HenryR-B/bio-robot/battery-motherboard/battery-motherboard.step

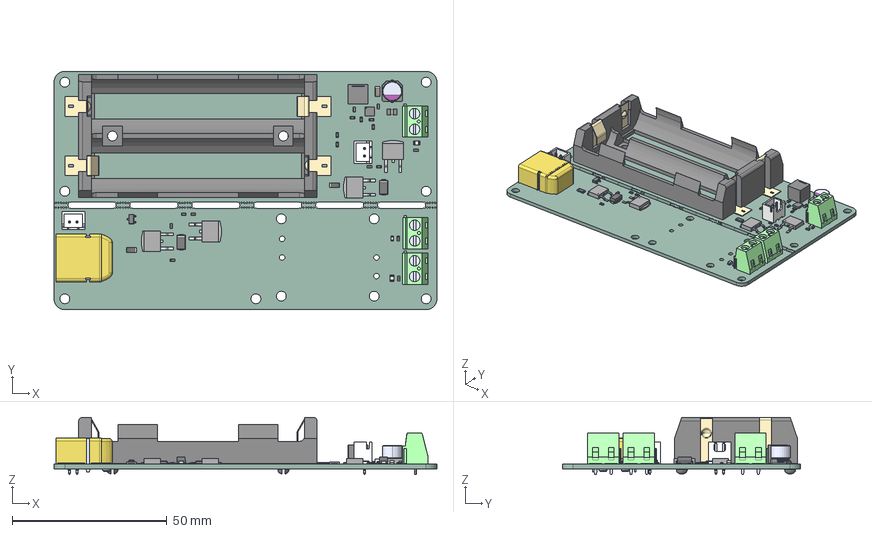
[picture p1: CAD file, 2026-03-27]
battery-motherboard/battery-motherboard.step
123.8 x 77.0 x 18.5 mm
LED_0805_2012Metric x 2
R_0603_1608Metric x 15
SOT23-3
282837-2--3DModel-STEP-269445 x 3
C_1206_3216Metric
D_SMA x 2
DPAK-3_ONS x 4
LMR51450SDRRR
LED_0603_1608Metric
B2B-XH-A_LF__SN_ x 2
C_0805_2012Metric x 2
C_0603_1608Metric x 2
XAL6060-472MEC
XT60PW-M
1048P
Fuse_1206_3216Metric x 2
10SVPC120MV
motherboard-esp32_PCB
