HenryR-B/bio-robot/control-board/control-board.step

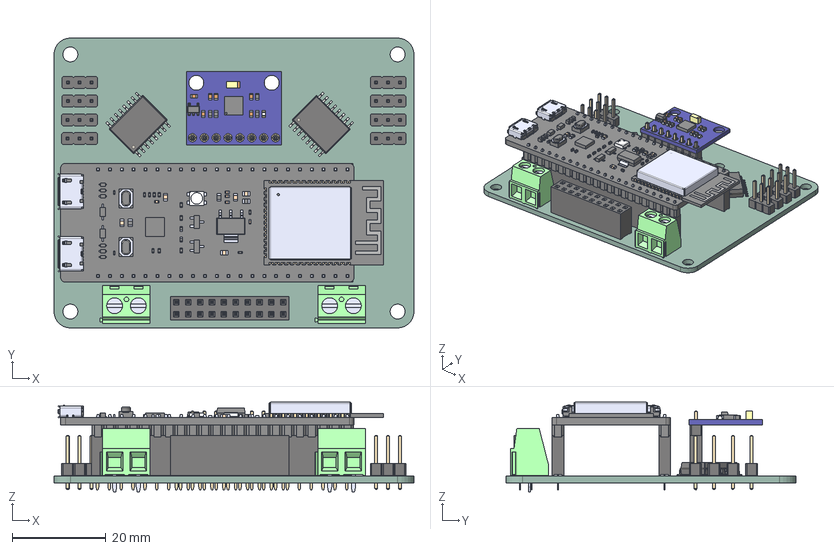
[picture p2: CAD file, 2026-04-10]
control-board/control-board.step
77.0 x 62.0 x 19.1 mm
282837-2--3DModel-STEP-269445 x 2
PinHeader_1x03_P2.54mm_Vertical x 8
SOIC-16W_7.5x10.3mm_P1.27mm x 2
PinSocket_2x10_P2.54mm_Vertical
ESP32-S3-DEVKITC-1-N8R8
PinSocket_1x22_P2.54mm_Vertical x 2
OC09600
PinHeader_1x08_P2.54mm_Vertical
PinSocket_1x08_P2.54mm_Vertical
servo-board_PCB
