HenryR-B/bio-robot/dc-dc-6.8V/dc-dc6.8V.step

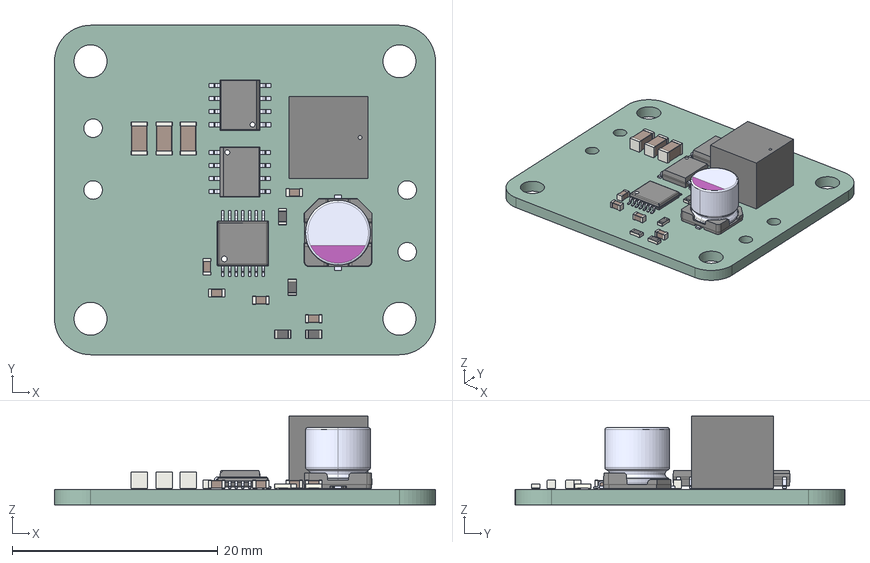
[picture p3: CAD file, 2026-03-26]
dc-dc-6.8V/dc-dc6.8V.step
37.0 x 32.0 x 8.61 mm
C_0603_1608Metric x 5
AO4354 x 2
C_1206_3216Metric x 3
IND_XAL7070_COC
10SVPC120MV
R_0603_1608Metric x 4
LM3150MHX_NOPB
dc-dc-6.8V_PCB
