HenryR-B/bio-robot/control-board/control-board.kicad_pcb

## KiCad design control-board/control-board.kicad_pcb (2026-03-26)

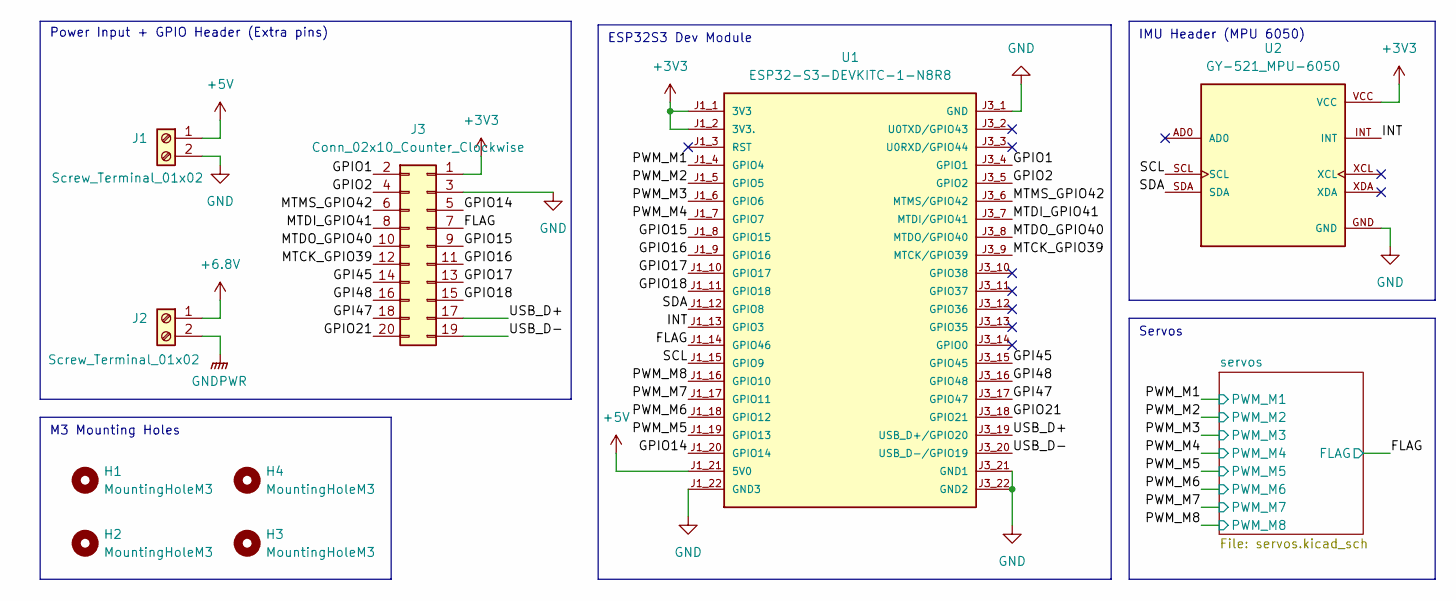
[picture p4: schematic control-board.kicad_sch]

Parts:
H1, H2, H3, H4: MountingHoleM3; MountingHole_3.2mm_M3_DIN965_Pad
J1, J2: Screw_Terminal_01x02; TerminalBlock_MaiXu_MX126-5.0-02P_1x02_P5.00mm
J3: Conn_02x10_Counter_Clockwise; PinSocket_2x10_P2.54mm_Vertical
U1: ESP32-S3-DEVKITC-1-N8R8
U2: GY-521_MPU-6050; MODULE_OC09600; PARTREV NA

Connections:
+3V3: J3.1, U1.J1_1 (3V3), U1.J1_2 (3V3.), U2.VCC; also elsewhere on the board
+5V: J1.1, U1.J1_21 (5V0)
+6.8V: J2.1; also elsewhere on the board
/FLAG: J3.7, U1.J1_14 (GPIO46); also elsewhere on the board
/GPI45: J3.14, U1.J3_15 (GPIO45)
/GPI47: J3.18, U1.J3_17 (GPIO47)
/GPI48: J3.16, U1.J3_16 (GPIO48)
/GPIO1: J3.2, U1.J3_4 (GPIO1)
/GPIO2: J3.4, U1.J3_5 (GPIO2)
/GPIO14: J3.5, U1.J1_20 (GPIO14)
/GPIO15: J3.9, U1.J1_8 (GPIO15)
/GPIO16: J3.11, U1.J1_9 (GPIO16)
/GPIO17: J3.13, U1.J1_10 (GPIO17)
/GPIO18: J3.15, U1.J1_11 (GPIO18)
/GPIO21: J3.20, U1.J3_18 (GPIO21)
/INT: U1.J1_13 (GPIO3), U2.INT
/MTCK_GPIO39: J3.12, U1.J3_9 (MTCK/GPIO39)
/MTDI_GPIO41: J3.8, U1.J3_7 (MTDI/GPIO41)
/MTDO_GPIO40: J3.10, U1.J3_8 (MTDO/GPIO40)
/MTMS_GPIO42: J3.6, U1.J3_6 (MTMS/GPIO42)
/PWM_M1: U1.J1_4 (GPIO4); also elsewhere on the board
/PWM_M2: U1.J1_5 (GPIO5); also elsewhere on the board
/PWM_M3: U1.J1_6 (GPIO6); also elsewhere on the board
/PWM_M4: U1.J1_7 (GPIO7); also elsewhere on the board
/PWM_M5: U1.J1_19 (GPIO13); also elsewhere on the board
/PWM_M6: U1.J1_18 (GPIO12); also elsewhere on the board
/PWM_M7: U1.J1_17 (GPIO11); also elsewhere on the board
/PWM_M8: U1.J1_16 (GPIO10); also elsewhere on the board
/SCL: U1.J1_15 (GPIO9), U2.SCL
/SDA: U1.J1_12 (GPIO8), U2.SDA
/USB_D+: J3.17, U1.J3_19 (USB_D+/GPIO20)
/USB_D-: J3.19, U1.J3_20 (USB_D-/GPIO19)
GND: J1.2, J3.3, U1.J1_22 (GND3), U1.J3_1 (GND), U1.J3_21 (GND1), U1.J3_22 (GND2), U2.GND; also elsewhere on the board
GNDPWR: J2.2; also elsewhere on the board

Notes on the sheet:
IMU Header (MPU 6050)
Servos
ESP32S3 Dev Module
M3 Mounting Holes
Power Input + GPIO Header (Extra pins)

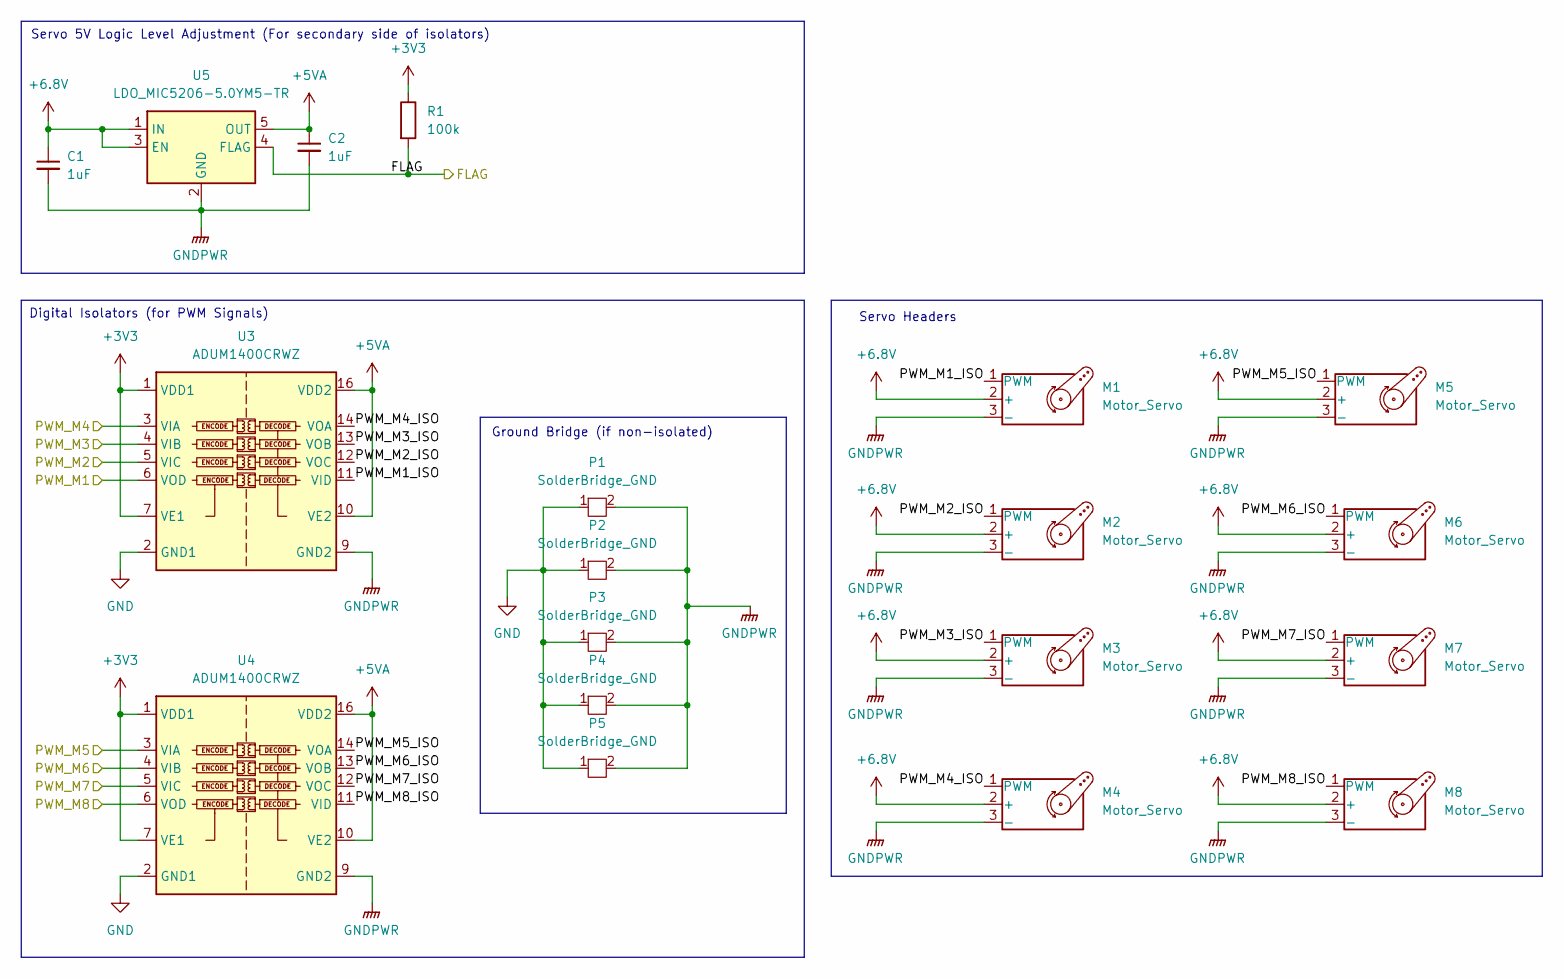
[picture p5: schematic servos.kicad_sch]

Parts:
C1, C2: 1uF; C_0603_1608Metric; MPN CL10A105KB8NNNC; LCSC C15849
M1, M2, M3, M4, M5, M6, M7, M8: Motor_Servo; PinHeader_1x03_P2.54mm_Vertical
P1, P2, P3, P4, P5: SolderBridge_GND
R1: 100k; R_0603_1608Metric; MPN 0603WAF1003T5E; JLC 0603
U3, U4: ADUM1400CRWZ; SOIC-16W_7.5x10.3mm_P1.27mm
U5: LDO_MIC5206-5.0YM5-TR; SOT-23-5

Connections:
+3V3: R1.1, U3.1 (VDD1), U3.7 (VE1), U4.1 (VDD1), U4.7 (VE1); also elsewhere on the board
+5VA: C2.1, U3.10 (VE2), U3.16 (VDD2), U4.10 (VE2), U4.16 (VDD2), U5.5 (OUT)
+6.8V: C1.1, M1.2 (+), M2.2 (+), M3.2 (+), M4.2 (+), M5.2 (+), M6.2 (+), M7.2 (+), M8.2 (+), U5.1 (IN), U5.3 (EN); also elsewhere on the board
/FLAG: R1.2, U5.4 (FLAG); also elsewhere on the board
/PWM_M1: U3.6 (VOD); also elsewhere on the board
/PWM_M2: U3.5 (VIC); also elsewhere on the board
/PWM_M3: U3.4 (VIB); also elsewhere on the board
/PWM_M4: U3.3 (VIA); also elsewhere on the board
/PWM_M5: U4.3 (VIA); also elsewhere on the board
/PWM_M6: U4.4 (VIB); also elsewhere on the board
/PWM_M7: U4.5 (VIC); also elsewhere on the board
/PWM_M8: U4.6 (VOD); also elsewhere on the board
/servos/PWM_M1_ISO: M1.1 (PWM), U3.11 (VID)
/servos/PWM_M2_ISO: M2.1 (PWM), U3.12 (VOC)
/servos/PWM_M3_ISO: M3.1 (PWM), U3.13 (VOB)
/servos/PWM_M4_ISO: M4.1 (PWM), U3.14 (VOA)
/servos/PWM_M5_ISO: M5.1 (PWM), U4.14 (VOA)
/servos/PWM_M6_ISO: M6.1 (PWM), U4.13 (VOB)
/servos/PWM_M7_ISO: M7.1 (PWM), U4.12 (VOC)
/servos/PWM_M8_ISO: M8.1 (PWM), U4.11 (VID)
GND: P1.1, P2.1, P3.1, P4.1, P5.1, U3.2 (GND1), U3.8 (GND1), U4.2 (GND1), U4.8 (GND1); also elsewhere on the board
GNDPWR: C1.2, C2.2, M1.3 (-), M2.3 (-), M3.3 (-), M4.3 (-), M5.3 (-), M6.3 (-), M7.3 (-), M8.3 (-), P1.2, P2.2, P3.2, P4.2, P5.2, U3.9 (GND2), U3.15 (GND2), U4.9 (GND2), U4.15 (GND2), U5.2 (GND); also elsewhere on the board

Notes on the sheet:
Digital Isolators (for PWM Signals)
Servo 5V Logic Level Adjustment (For secondary side of isolators)
Ground Bridge (if non-isolated)
Servo Headers

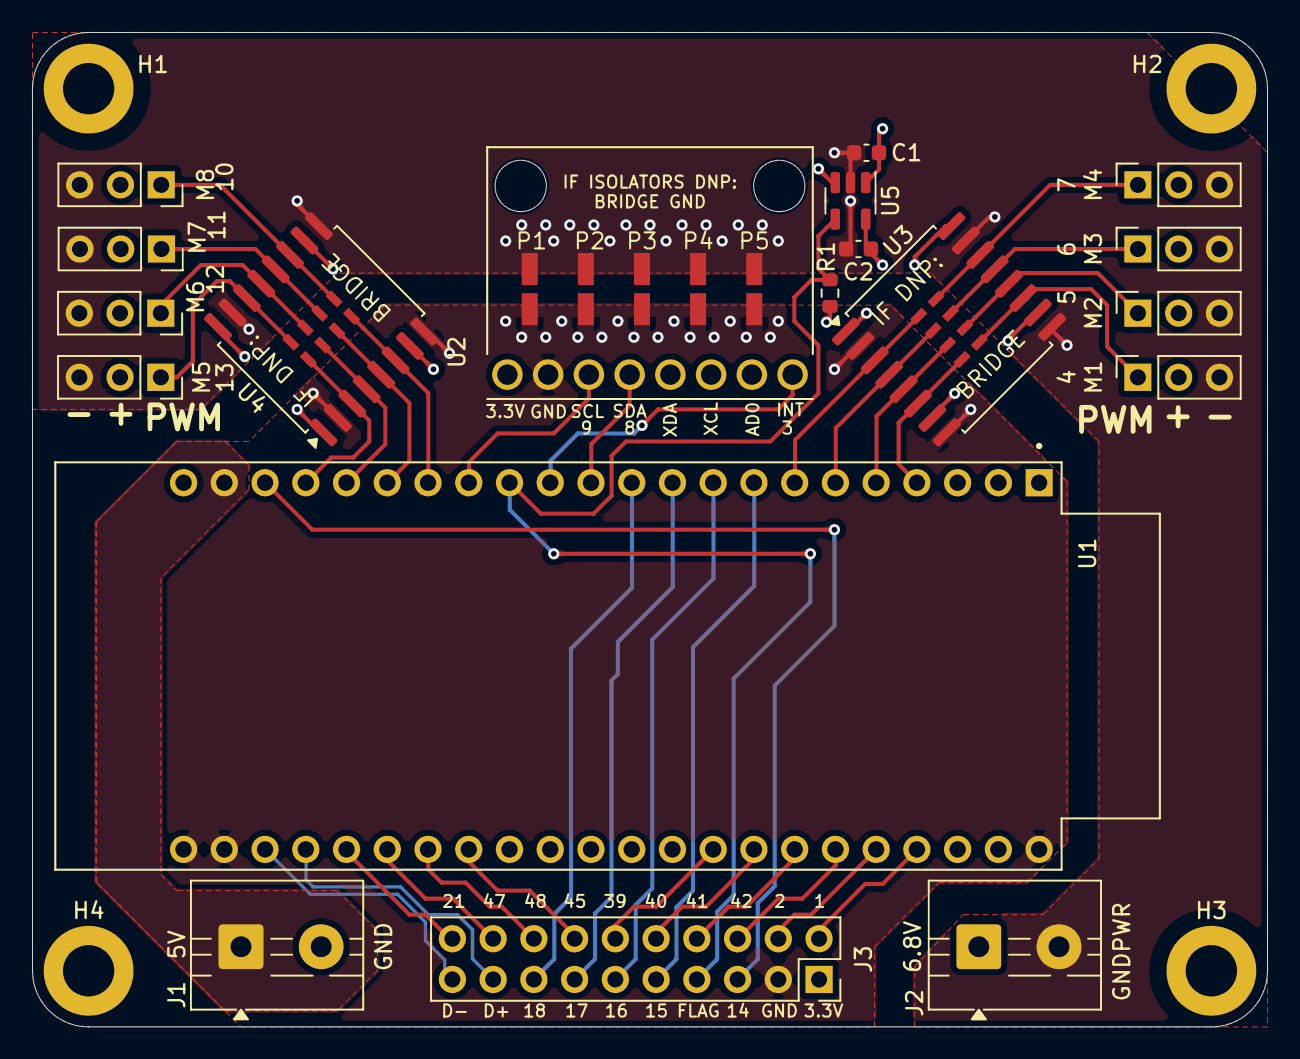
[picture p6: board control-board.kicad_pcb from above]

Board: 4 copper layers, 77.0 x 62.0 mm, 28 parts (0 on the bottom side), 43 nets.
