HenryR-B/bio-robot/battery-motherboard/battery-motherboard.kicad_pcb

## KiCad design battery-motherboard/battery-motherboard.kicad_pcb (2026-04-10)

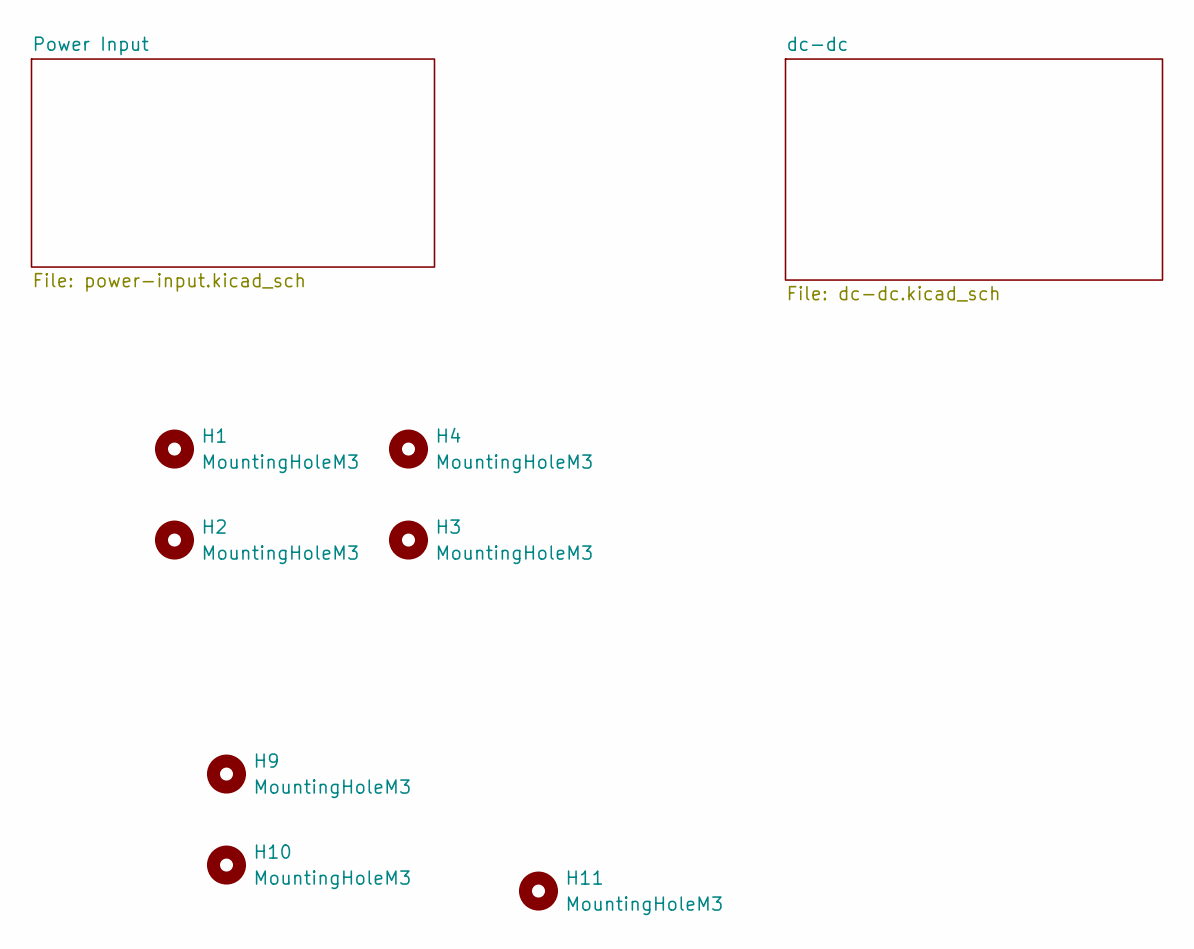
[picture p7: schematic battery-motherboard.kicad_sch]

Parts:
H1, H2, H3, H4, H9, H10, H11: MountingHoleM3; MountingHole_3.2mm_M3_DIN965_Pad

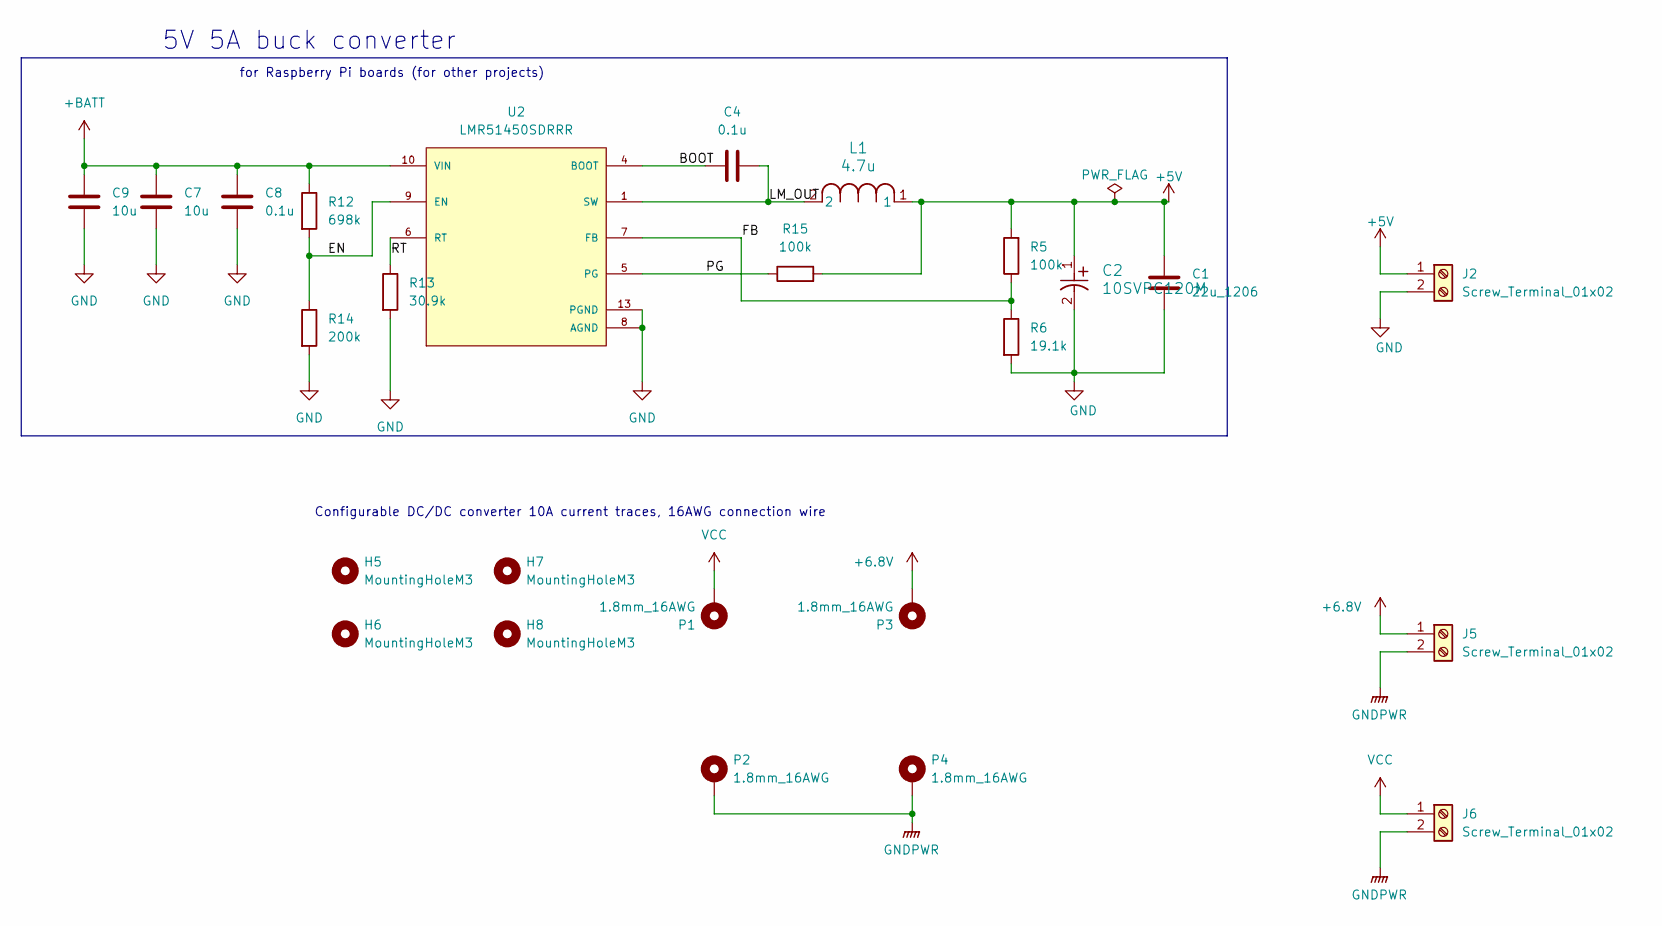
[picture p8: schematic dc-dc.kicad_sch]

Parts:
C1: 22u_1206; C_1206_3216Metric; MPN CL31A226KAHNNNE; JLC 0805
C2: 10SVPC120M; CAP_10SVPC120MV; LCSC C178336
C4, C8: 0.1u; C_0603_1608Metric; MPN CC0603KRX7R9BB104; JLC 0603
C7, C9: 10u; C_0805_2012Metric; MPN GRM21BR61H106KE43L; JLC 0805
H5, H6, H7, H8: MountingHoleM3; MountingHole_3.2mm_M3_DIN965_Pad
J2, J5, J6: Screw_Terminal_01x02; TerminalBlock_MaiXu_MX126-5.0-02P_1x02_P5.00mm
L1: 4.7u; IND_XAL6060-472MEC; MPN XAL6060-472MEB; LCSC C7421717
P1, P2, P3, P4: 1.8mm_16AWG; SolderPad_TH_16AWG_1.8mm
R5, R15: 100k; R_0603_1608Metric; MPN 0603WAF1003T5E; JLC 0603
R6: 19.1k; R_0603_1608Metric; MPN 0603WAF1912T5E; JLC 0603
R12: 698k; R_0603_1608Metric; MPN 0603WAF6983T5E; JLC 0603
R13: 30.9k; R_0603_1608Metric; MPN 0603WAF3092T5E; JLC 0603
R14: 200k; R_0603_1608Metric; MPN 0603WAF2003T5E; JLC 0603
U2: LMR51450SDRRR; CONV_LMR51450SDRRR; PARTREV December 2022

Connections:
+5V: C1.1, C2.1, J2.1, L1.1, R5.2, R15.2; also elsewhere on the board
+6.8V: J5.1, P3.1 (1_1); also elsewhere on the board
+BATT: C7.1, C8.2, C9.1, R12.1, U2.10 (VIN), U2.11 (VIN), U2.12 (VIN); also elsewhere on the board
/dc-dc/BOOT: C4.1, U2.4 (BOOT)
/dc-dc/EN: R12.2, R14.1, U2.9 (EN)
/dc-dc/FB: R5.1, R6.1, U2.7 (FB)
/dc-dc/LM_OUT: C4.2, L1.2, U2.1 (SW), U2.2 (SW), U2.3 (SW)
/dc-dc/PG: R15.1, U2.5 (PG)
/dc-dc/RT: R13.1, U2.6 (RT)
GND: C1.2, C2.2, C7.2, C8.1, C9.2, J2.2, R6.2, R13.2, R14.2, U2.8 (AGND), U2.13 (PGND); also elsewhere on the board
GNDPWR: J5.2, J6.2, P2.1 (1_1), P4.1 (1_1); also elsewhere on the board
VCC: J6.1, P1.1 (1_1); also elsewhere on the board

Notes on the sheet:
Configurable DC/DC converter 10A current traces, 16AWG connection wire
5V 5A buck converter
for Raspberry Pi boards (for other projects)

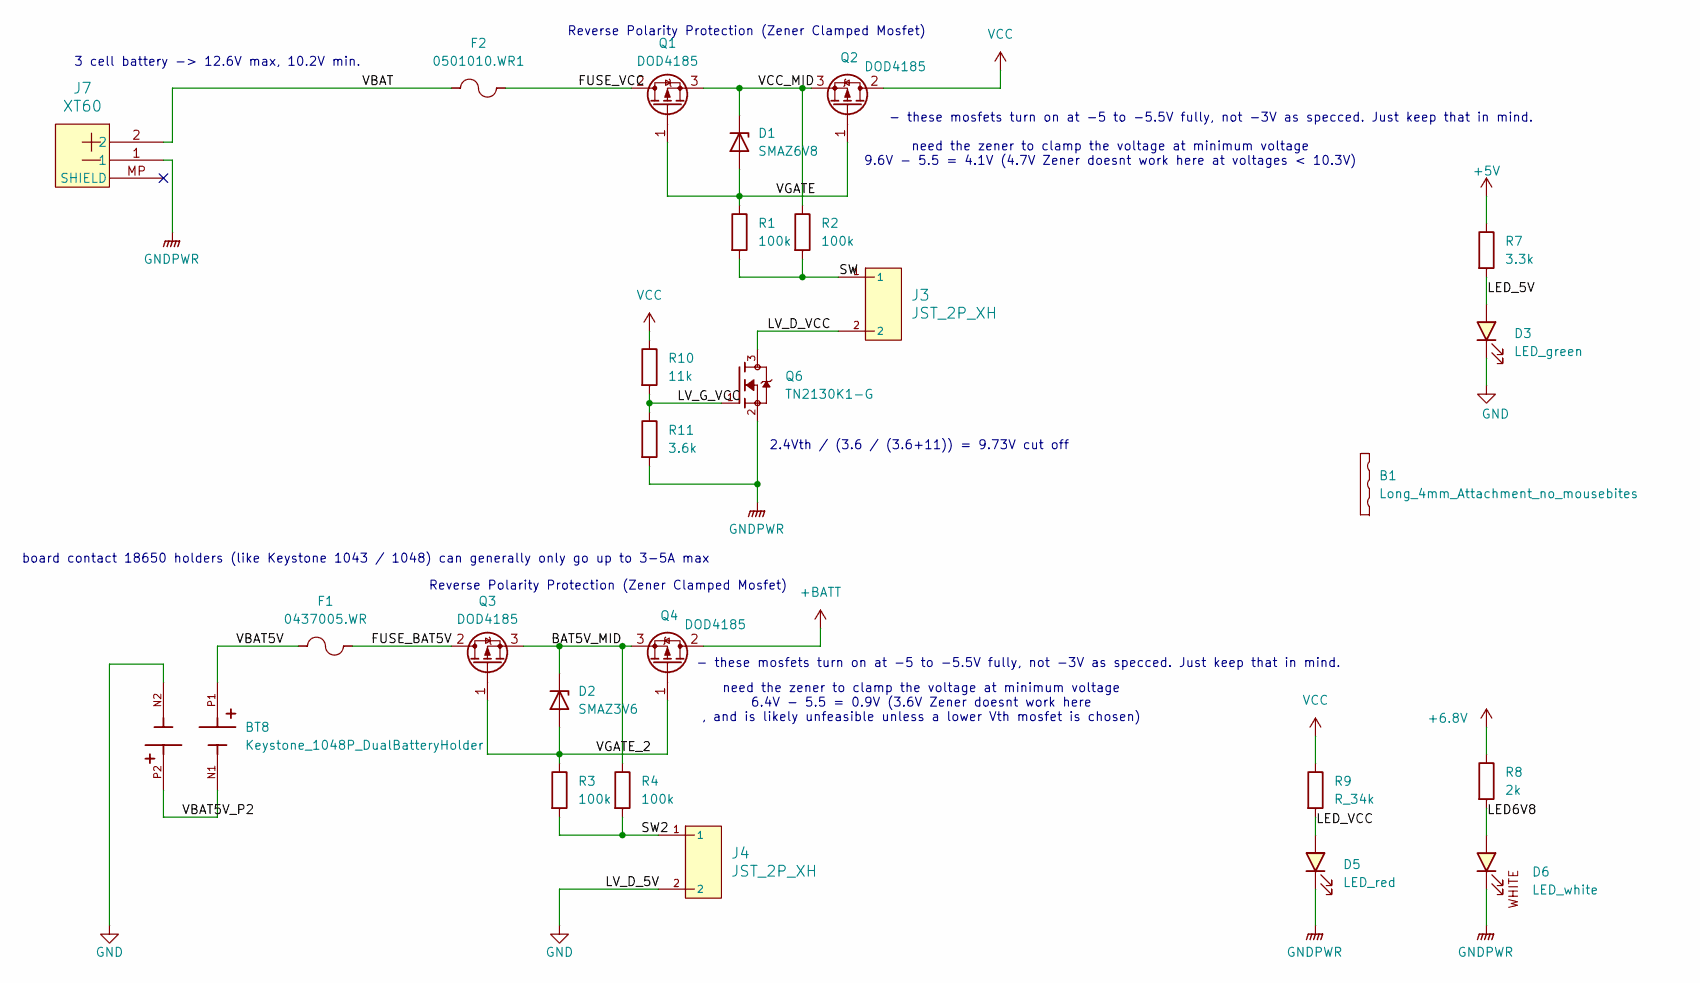
[picture p9: schematic power-input.kicad_sch]

Parts:
B1: Long_4mm_Attachment_no_mousebites; Long_4mm_attachment_no_mouse_bites
BT8: Keystone_1048P_DualBatteryHolder; BAT_1048P; PARTREV E; DigiKey_Part_Number 36-1042-ND
D1: SMAZ6V8; D_SMA; MPN SMAZ6V8; JLC DO-214AC(SMA)
D2: SMAZ3V6; D_SMA; MPN 1SMA4729A; LCSC C19077475
D3: LED_green; LED_0805_2012Metric; MPN KT-0805G; JLC 0805
D5: LED_red; LED_0805_2012Metric; MPN NCD0805R1; JLC 0805
D6: LED_white; LED_0603_1608Metric; MPN KT-0603W; JLC 0603
F1: 0437005.WR; Fuse_1206_3216Metric; MPN 0501010.WR1; JLC 1206
F2: 0501010.WR1; Fuse_1206_3216Metric; MPN 0501010.WR1; JLC 1206
J3, J4: JST_2P_XH; JST_B2B-XH-A_LF__SN_
J7: XT60; AMASS_XT60PW-M
Q1, Q2, Q3, Q4: DOD4185; DPAK-3_ONS; MPN DOD4185; LCSC C41430591
Q6: TN2130K1-G; SOT95P240X111-3N; MPN TN2130K1-G; JLC SOT-23-3
R1, R2, R3, R4: 100k; R_0603_1608Metric; MPN 0603WAF1003T5E; JLC 0603
R7: 3.3k; R_0603_1608Metric; MPN 0603WAF3301T5E; JLC 0603
R8: 2k; R_0603_1608Metric; MPN 0603WAF2001T5E; JLC 0603
R9: R_34k; R_0603_1608Metric; MPN 0603WAF3402T5E; JLC 0603
R10: 11k; R_0603_1608Metric; MPN 0603WAF1102T5E; JLC 0603
R11: 3.6k; R_0603_1608Metric; MPN 0603WAF3601T5E; JLC 0603

Connections:
+5V: R7.1; also elsewhere on the board
+6.8V: R8.1; also elsewhere on the board
+BATT: Q4.2 (D); also elsewhere on the board
/Power Input/BAT5V_MID: D2.1 (K), Q3.3 (S), Q4.3 (S), R4.1
/Power Input/FUSE_BAT5V: F1.2, Q3.2 (D)
/Power Input/FUSE_VCC: F2.2, Q1.2 (D)
/Power Input/LED6V8: D6.2 (A), R8.2
/Power Input/LED_5V: D3.2 (A), R7.2
/Power Input/LED_VCC: D5.2 (A), R9.2
/Power Input/LV_D_VCC: J3.2, Q6.3
/Power Input/LV_G_VCC: Q6.1, R10.2, R11.1
/Power Input/SW: J3.1, R1.2, R2.2
/Power Input/SW2: J4.1, R3.2, R4.2
/Power Input/VBAT: F2.1, J7.2
/Power Input/VBAT5V: BT8.P1, F1.1
/Power Input/VBAT5V_P2: BT8.N1, BT8.P2
/Power Input/VCC_MID: D1.1 (K), Q1.3 (S), Q2.3 (S), R2.1
/Power Input/VGATE: D1.2 (A), Q1.1 (G), Q2.1 (G), R1.1
/Power Input/VGATE_2: D2.2 (A), Q3.1 (G), Q4.1 (G), R3.1
GND: BT8.N2, D3.1 (K), J4.2; also elsewhere on the board
GNDPWR: D5.1 (K), D6.1 (K), J7.1, Q6.2, R11.2; also elsewhere on the board
VCC: Q2.2 (D), R9.1, R10.1; also elsewhere on the board

Notes on the sheet:
3 cell battery -> 12.6V max, 10.2V min.
Reverse Polarity Protection (Zener Clamped Mosfet)
2.4Vth / (3.6 / (3.6+11)) = 9.73V cut off
board contact 18650 holders (like Keystone 1043 / 1048) can generally only go up to 3-5A max
need the zener to clamp the voltage at minimum voltage 9.6V - 5.5 = 4.1V (4.7V Zener doesnt work here at voltages < 10.3V)
- these mosfets turn on at -5 to -5.5V fully, not -3V as specced. Just keep that in mind.
need the zener to clamp the voltage at minimum voltage 6.4V - 5.5 = 0.9V (3.6V Zener doesnt work here , and is likely unfeasible unless a lower Vth mosfet is chosen)

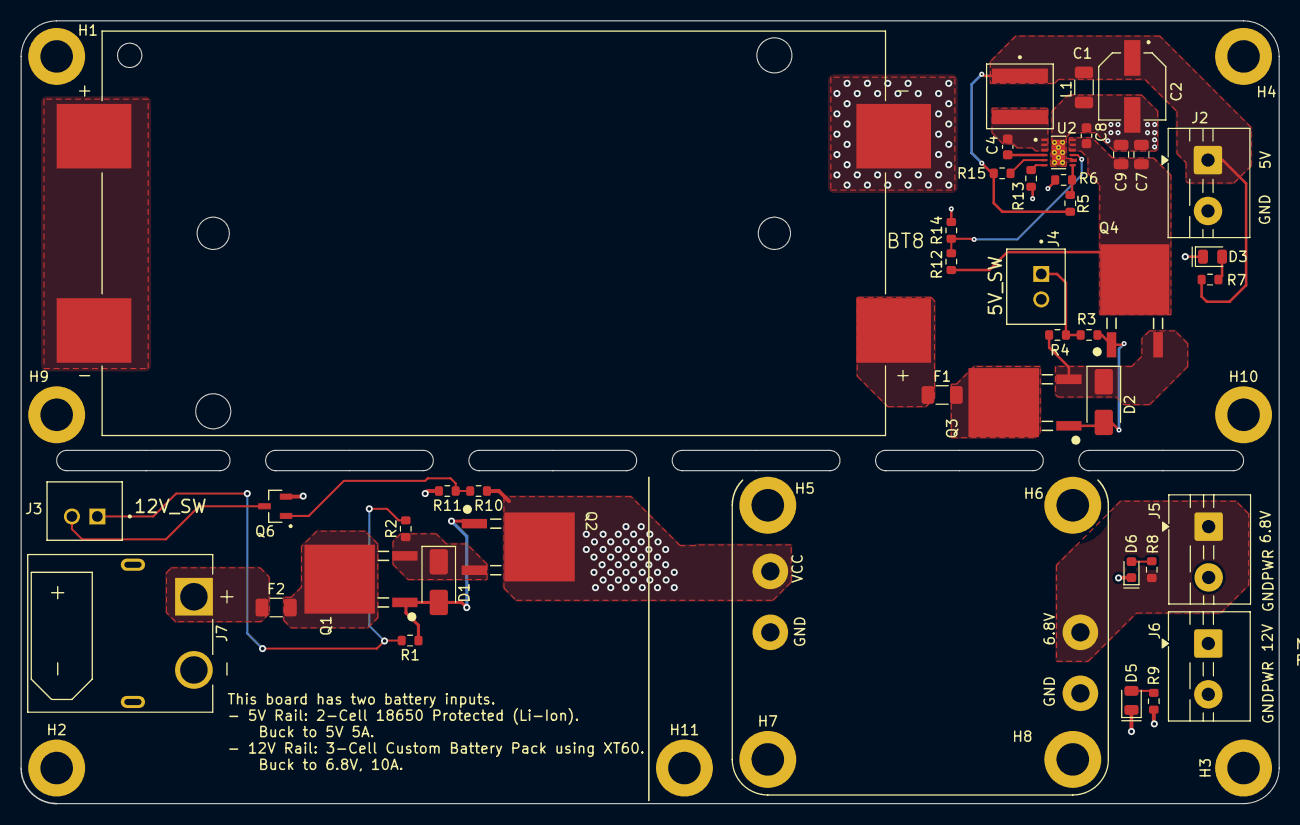
[picture p10: board battery-motherboard.kicad_pcb from above]

Board: 4 copper layers, 123.8 x 77.0 mm, 58 parts (0 on the bottom side), 28 nets.
