HenryR-B/bio-robot/dc-dc-6.8V/dc-dc-6.8V.kicad_pcb

## KiCad design dc-dc-6.8V/dc-dc-6.8V.kicad_pcb (2026-03-27)

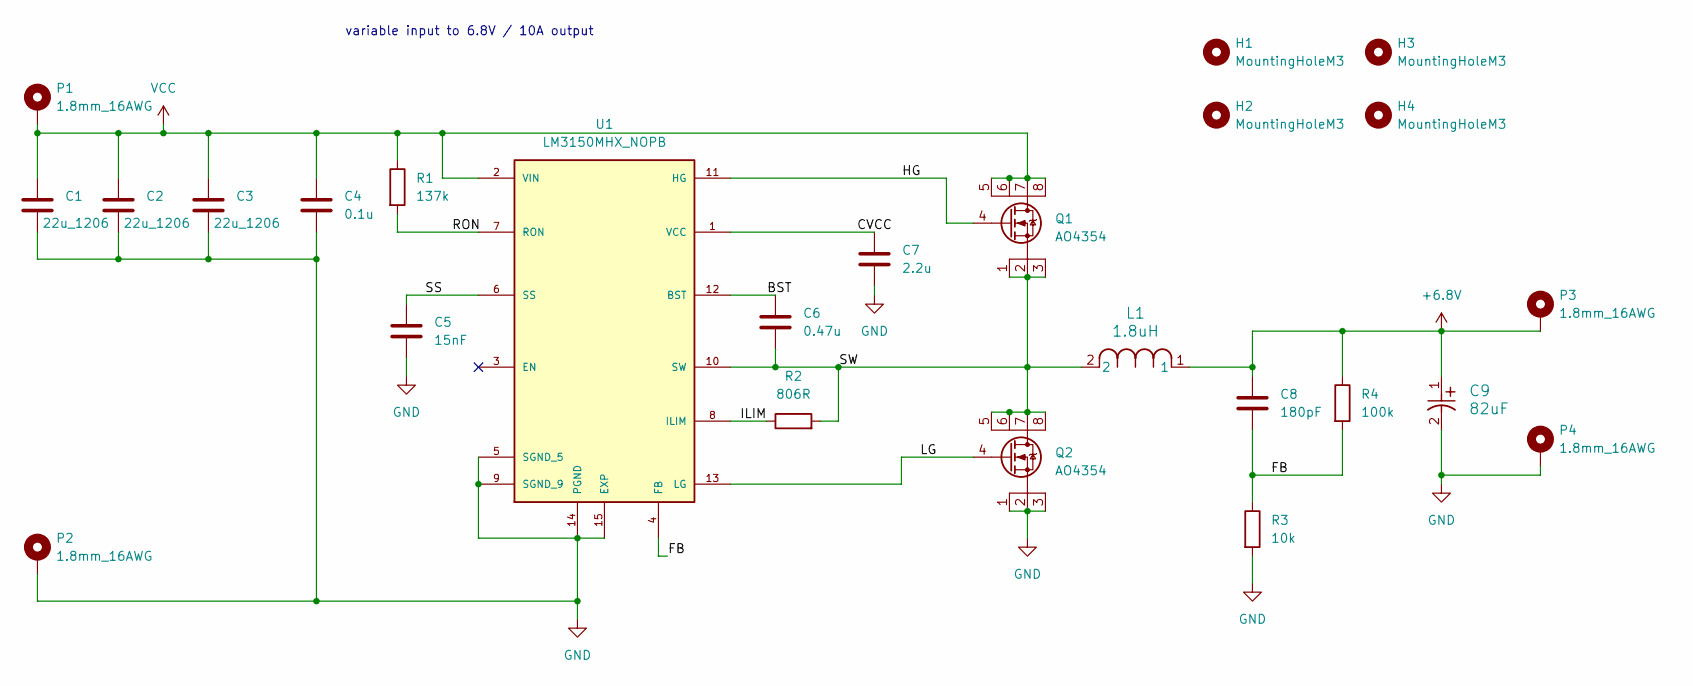
[picture p11: schematic dc-dc-6.8V.kicad_sch]

Parts:
C1, C2, C3: 22u_1206; C_1206_3216Metric; MPN CL31A226KAHNNNE; JLC 0805
C4: 0.1u; C_0603_1608Metric; MPN CC0603KRX7R9BB104; JLC 0603
C5: 15nF; C_0603_1608Metric; MPN 0603B153K500NT; JLC 0603
C6: 0.47u; C_0603_1608Metric; MPN CL10B474KA8NNNC; JLC 0603
C7: 2.2u; C_0603_1608Metric; MPN CL10A225KO8NNNC; JLC 0603
C8: 180pF; C_0603_1608Metric; MPN CL10C181JB8NNNC; JLC 0603
C9: 82uF; CAP_10SVPC120MV; MPN 10SVPC120MV; LCSC C178336
H1, H2, H3, H4: MountingHoleM3; MountingHole_3.2mm_M3_DIN965_Pad
L1: 1.8uH; IND_XAL7070_COC; MPN XAL7070-182MEC; LCSC C3911679
P1, P2, P3, P4: 1.8mm_16AWG; SolderPad_TH_16AWG_1.8mm
Q1, Q2: AO4354; SOIC-8_3.9x4.9mm_P1.27mm; MPN AO4354; LCSC C61955
R1: 137k; R_0603_1608Metric; MPN 0603WAF1373T5E; JLC 0603
R2: 806R; R_0603_1608Metric; MPN 0603WAF8060T5E; JLC 0603
R3: 10k; R_0603_1608Metric; MPN 0603WAF1002T5E; JLC 0603
R4: 100k; R_0603_1608Metric; MPN 0603WAF1003T5E; JLC 0603
U1: LM3150MHX_NOPB; SOP65P640X110-15N; PARTREV G

Connections:
+6.8V: C8.1, C9.1, L1.1, P3.1 (1_1), R4.1
/BST: C6.1, U1.12 (BST)
/CVCC: C7.1, U1.1 (VCC)
/FB: C8.2, R3.1, R4.2, U1.4 (FB)
/HG: Q1.4 (G), U1.11 (HG)
/ILIM: R2.1, U1.8 (ILIM)
/LG: Q2.4 (G), U1.13 (LG)
/RON: R1.2, U1.7 (RON)
/SS: C5.1, U1.6 (SS)
/SW: C6.2, L1.2, Q1.1 (S), Q1.2 (S), Q1.3 (S), Q2.5 (D), Q2.6 (D), Q2.7 (D), Q2.8 (D), R2.2, U1.10 (SW)
GND: C1.2, C2.2, C3.2, C4.2, C5.2, C7.2, C9.2, P2.1 (1_1), P4.1 (1_1), Q2.1 (S), Q2.2 (S), Q2.3 (S), R3.2, U1.5 (SGND_5), U1.9 (SGND_9), U1.14 (PGND), U1.15 (EXP)
VCC: C1.1, C2.1, C3.1, C4.1, P1.1 (1_1), Q1.5 (D), Q1.6 (D), Q1.7 (D), Q1.8 (D), R1.1, U1.2 (VIN)

Notes on the sheet:
variable input to 6.8V / 10A output

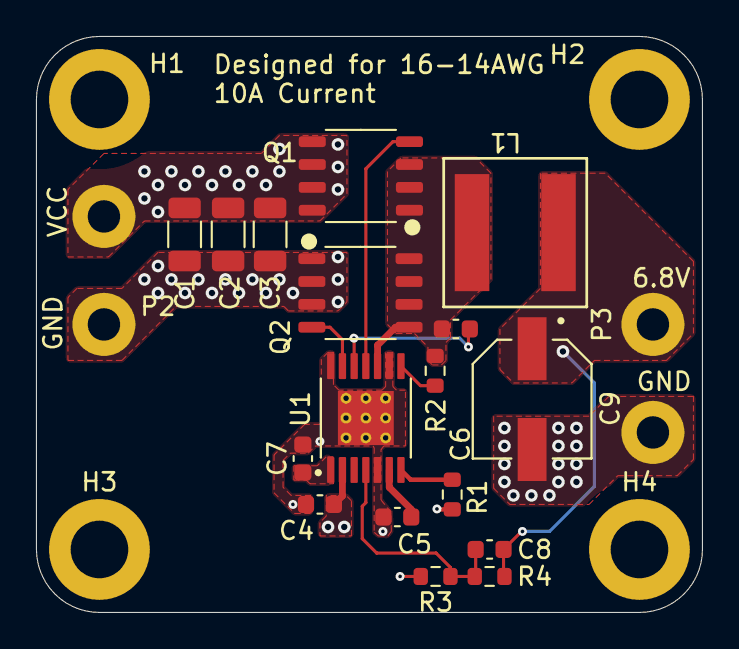
[picture p12: board dc-dc-6.8V.kicad_pcb from above]

Board: 4 copper layers, 37.0 x 32.0 mm, 25 parts (0 on the bottom side), 12 nets.
