HenryR-B/bio-robot/(commit log)

2026-03-03 proof of concept
    [dc-dc.kicad_sch, motherboard-esp32.kicad_pcb, motherboard-esp32.kicad_sch, power-input.kicad_sch]
2026-03-04 split into two boards for dc/dc converter
    [dc-dc-6.8V.kicad_pcb, dc-dc-6.8V.kicad_sch, dc-dc.kicad_sch, motherboard-esp32.kicad_pcb, power-input.kicad_sch]
2026-03-13 board done
    [CONTROL_BOARD_bom.csv, CONTROL_BOARD_designators.csv, CONTROL_BOARD_positions.csv, servo-board.kicad_pcb, servo-board.kicad_sch, servos.kicad_sch]
2026-03-13 control board ordered
    [CONTROL_BOARD_bom.csv, CONTROL_BOARD_designators.csv, CONTROL_BOARD_positions.csv, servo-board.kicad_pcb, servo-board.kicad_sch, servos.kicad_sch]
2026-03-24 board files
    [dc-dc-6.8V.kicad_pcb, motherboard-esp32.kicad_pcb]
2026-03-25 update to silkscreen
    [dc-dc-6.8V.kicad_sch, motherboard-esp32.kicad_pcb]
2026-03-25 adding leds
    - need to add UVLO
    [motherboard-esp32.kicad_pcb, motherboard-esp32.kicad_sch, power-input.kicad_sch]
2026-03-26 5V 5A version
    [battery-motherboard.step, dc-dc-6.8V.kicad_pcb, dc-dc-6.8V.kicad_sch, dc-dc.kicad_sch, dc-dc6.8V.step, motherboard-esp32.kicad_pcb, motherboard-esp32.kicad_sch, power-input.kicad_sch]
2026-04-10 zener notes
    [power-input.kicad_sch]
2026-04-10 control board name change
    [control-board.kicad_pcb, control-board.kicad_sch]
